Silas-Oliver/neurova/login-art.jpg

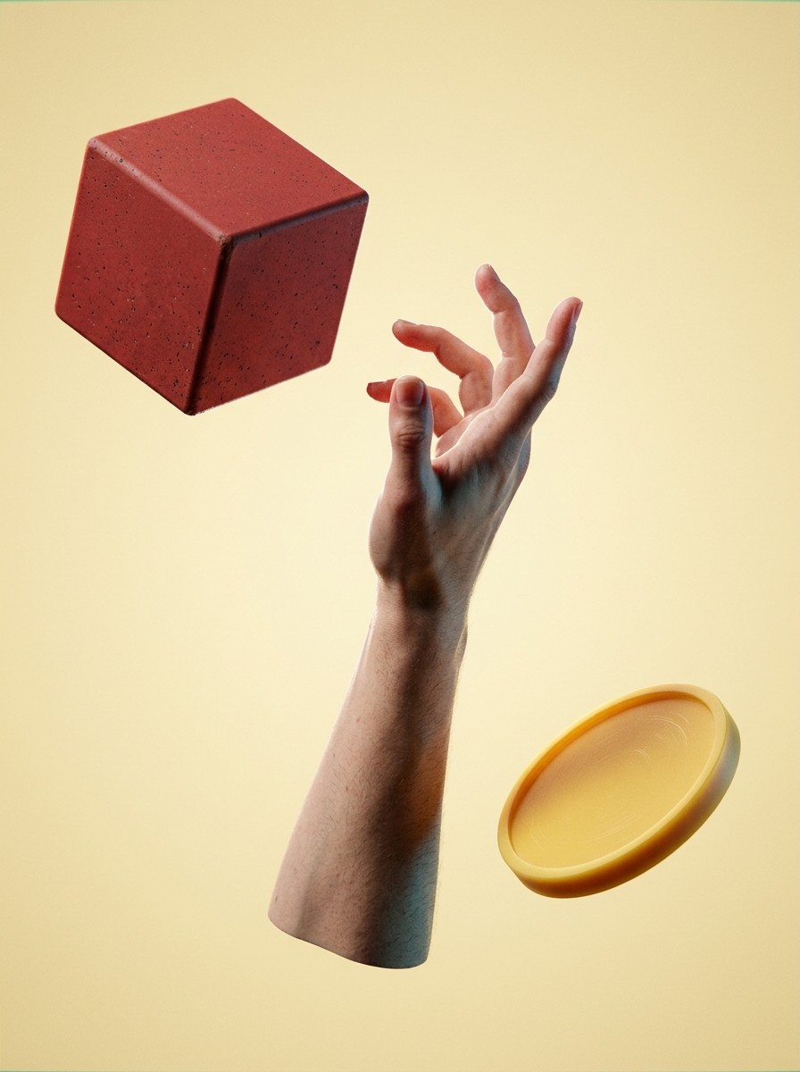
login-art.jpg
