Silas-Oliver/neurova/(commit log)

2026-09-26 EMG Tweak #2
    Retune the live view's detection constants for the real signal.
    Bench measurements finally gave concrete numbers: the module rests at
    344 and reaches 346-347 on a hard clench, with a peak-to-peak spread
    inside each sampling window of 0-1 counts. So the signal is 2-3 counts
    on a noise floor of roughly half a count -- far quieter, and far
    smaller, than the constants assumed.
    Those constants were tuned against an earlier, much noisier capture
    (339 +/- 5) and were blocking detection outright rather than protecting
    against false positives:
    - EMG_MIN_STDDEV_FLOOR 5 -> 0.5. One ADC count is the smallest real
    difference; a floor of 5 forced the baseline to look five times
    noisier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
2026-09-26 Plotter Tweak #2
    Stop onset markers from taking over the plot.
    Each detected onset was drawn as a full-height vertical rule. One is
    readable; several on screen at once dominate the plot and bury the trace
    they are supposed to annotate. The lower detection floor from the last
    change fires more often, which made this worse rather than better.
    Each onset is now a dot sitting on the smoothed trace, with a short tick
    at the top edge so it stays findable when the trace runs near the floor.
    That also says more than the rule did: a full-height line marks a moment
    in time but not where on the curve the onset was judged to happen, while
    a dot on the trace shows both.
    Refractory period also goes fro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
2026-09-26 Plotter Tweak #3
    One marker per contraction, and a quieter marker.
    Holding a clench produced two or three onset markers instead of one.
    Cause: real muscle is not steady while held, and that tremor re-crosses
    the slope threshold repeatedly. A fixed refractory cannot fix this --
    lengthen it enough to swallow the tremor and two genuine contractions
    close together merge into one.
    An onset now latches: it fires once, then stays quiet until the signal
    has fallen most of the way back toward rest. Judging the end of an
    excursion by where the signal actually is, rather than by a timer, marks
    one contraction once whether it lasts half a second or five, while two
    separate contractions still read as t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
2026-09-26 Plotter Tweak #4
    Show movement by colouring the trace instead of marking it.
    The smoothed line is now neutral while resting and green for the whole
    stretch the board judges to be a contraction, replacing the onset dots.
    Colouring the span says more than a marker did. A dot marks when a
    contraction started but nothing about how long it lasted; the coloured
    run shows both, and where it begins is still exactly the detected onset.
    It also annotates the plot without drawing anything on top of it, which
    is what made the previous markers crowd the view.
    The line is drawn in runs of consecutive same-state samples rather than
    as one path, each run starting a sample early so the runs join without
    g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
2026-09-26 Plotter Tweak #5
    Give the EMG live view the home page scope's instrument look.
    The panel now reuses the hero widget's furniture: the 22px graph-paper
    grid behind the trace, IBM Plex Mono labels, a large raw readout, and a
    footer stat row. The canvas is transparent and sits above the grid
    rather than covering it, so the trace reads against graph paper the way
    the home-page widget does.
    Trace colours move to the scope palette -- #5fbf8f for a contraction,
    #7fa89c while resting -- instead of the site's status green and white,
    so the plot belongs to the panel it sits in.
    The footer now carries information that was previously buried in a
    sentence: the captured baseline and the rise the board i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
2026-09-26 Plotter Tweak #6
    Tighten the EMG scope's layout and stop the trace ending short.
    Three things, all from looking at it rather than reasoning about it.
    The trace did not reach the panel edges. Two causes: the plot buffer
    started empty and grew in from the left, so the line only covered part
    of the width for the first several seconds and again after every
    restart; and a 2px stroke sitting exactly on x=0 only shows half its
    width. The buffer is now prefilled at the resting level once the
    baseline is known, and the x mapping insets by a pixel. The trace now
    spans column 1 to 598 of 600 from the first live sample.
    The panel was too airy. The hero scope can breathe because it is a hero;
    this one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
2026-09-26 Plotter Tweak #7
    Make a resting trace visibly live, and stop the baseline hiding under it.
    A flat signal gave no sign the plot was running at all. The panel's grid
    comes from CSS and is static, the trace does not move when the signal is
    steady, and the baseline was drawn before the trace, so at rest the
    trace sat exactly on it and covered it. Frozen and working looked
    identical.
    The canvas now paints its own copy of the grid -- same 22px pitch and
    weight, so it reads as continuous with the panel -- and scrolls the
    vertical lines with incoming samples. Data flowing is now visible
    regardless of what the signal is doing. Verified on a perfectly constant
    344: gridlines step 13,35,57 -> 4,26,48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
2026-09-26 Plotter Tweak #8
    Render the EMG canvas at native resolution, and keep one grid.
    The canvas element had a fixed 600x150 backing store but is laid out at
    100% of the panel width. Measured live that is 787 CSS pixels, so
    everything drawn on it was stretched 1.31x horizontally and not at all
    vertically, then resampled. Grid squares were not square, and the trace
    and gridlines were soft -- the "low quality" look.
    The backing store is now sized to the element's measured size times the
    display's pixel ratio, with the context scaled to match, so a pixel
    drawn is a pixel shown. On this display that is 1574x300 backing for
    787x150 CSS at dpr 2. Measured after the change, vertical and horizontal
    grid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
2026-09-26 Plotter Tweak #9
    Restore the scope look with a static grid.
    Brings back Plotter Tweaks #5 through #8 -- the instrument styling, the
    STATE / RAW / BASELINE / ONSET footer, the native-resolution canvas and
    the full-width prefilled trace -- without the scrolling gridlines.
    With the grid no longer moving, it goes back to being the panel's own
    CSS grid covering the whole card, the way the hero scope does it, and
    the canvas is transparent over it again. The canvas only had to paint
    its own grid in order to scroll it; a static grid drawn twice in two
    places was what could never line up.
    The canvas keeps its native-resolution sizing, which was never about the
    grid: the element is laid out at 787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
2026-09-26 Plotter Tweak #10
    Travel the baseline's dashes with the data.
    A steady signal made the plot indistinguishable from a frozen one, which
    is what the scrolling grid had been there for before it was dropped for
    never lining up with the panel's own grid. The baseline is a better
    place for that cue: it is one line the canvas already owns and draws
    last, so it cannot fall out of alignment with anything.
    Its dashes now advance at the same pixels-per-sample the trace scrolls
    at, so the line visibly travels whatever the signal is doing.
    The gap is three times the dash rather than equal to it. A sample
    advances the pattern by w/199 pixels, near 4, so the original 8px period
    stepped half a period per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
2026-09-26 Menu Tweak #1
    Clean up the test menu, and fix its Calibrate copy.
    The Calibrate card read "Record a baseline with no electrodes on skin."
    That is the opposite of what calibration is: the screen it opens says to
    place the electrodes at your best, firmest contact first. A baseline
    captured off-skin would be meaningless and every later verdict would be
    judged against it, so this is worth fixing regardless of the layout.
    Layout: five cards in a two-column grid left an orphaned fifth cell, and
    all five carried the same visual weight despite being three different
    kinds of thing -- two that work, two that do not exist yet, and a bench
    tool that is not a test at all.
    The four real tests now fill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
2026-09-26 Menu Tweak #2
    Relay the test menu as one sequence instead of a grid of cards.
    The grid was the wrong shape for what this is. The tests are a sequence,
    not a set of equal choices -- a contact test means nothing without a
    calibration behind it -- but four identical boxes said the opposite, and
    a fifth card for a bench tool that is not a test at all had nowhere to
    sit. The panel also forces a 340px minimum height while the grid carried
    margin-top:auto, so the cards floated in the middle of a mostly empty
    box.
    They are now one bordered list of numbered rows, matching the 01/02/03
    step list already used on the Calibrate screen, so the two screens share
    an idiom. Each row is an index, a name, a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
2026-09-26 Data Tab #1
    Log real sessions, and make the Data page show them.
    Every calibration and contact test now writes a dated record to
    users/{uid}/sessions -- the subcollection the existing security rule's
    {document=**} wildcard already covers. Writes are fire-and-forget: a
    session that fails to save must never interrupt a test already run on
    someone's arm.
    Each record carries the circuit it was measured through. The firmware
    gained a CONFIG line reporting its fixed resistor and ADC reference, and
    the site attaches those to every session, for the same reason the EEPROM
    stores them beside the baseline: a resistance is only comparable against
    another taken through the same divider, so a resistor s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
2026-09-26 Data Tab #2
    Reload the Data page on every visit, not just the first.
    Sessions are written by running a test on the Test menu, so the common
    path is to log one and come straight here -- and loading once per page
    load meant exactly that session was the one missing, until a manual
    refresh or a reload. The read is small, and a superseded load already
    discards its own result, so reloading per visit is safe.
    Verified: log a calibration while on another page, return to Data, and
    the new session is at the top of the log with the baseline chart going
    from three points to four.
2026-09-27 Account Tweak #2
    Light theme for the sign-in page, and close the gap down its middle.
    Drops the dark treatment for the site's own palette -- background,
    panel, borders, teal primary and ink all come from the existing
    variables, so the page no longer jumps from dark to light on the way
    into the tool. The card, buttons and inputs go back to inheriting the
    site's styles rather than overriding them, which is also less to keep in
    step later.
    The gap: the grid filled the viewport and each of its two columns
    centred its own contents, so on a wide screen the form drifted left and
    the artwork right, leaving a void between them that grew with the
    window. Measured at 1440px it was about 550px across.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
2026-09-27 Account Tweak #3
    Scale up the sign-in page.
    Everything grows together rather than a few pieces in isolation: the
    grid cap 1080 to 1260, the headline 40 to 52, the form and card 390 to
    450, the artwork 440 to 560 wide, and the card's own padding, labels,
    inputs, buttons and toggle by matching amounts. Scaling one element
    alone would have thrown the proportions between them.
    Measured at 1440x900: card 450, artwork 558x747, a 64px gap, no
    horizontal overflow and the artwork still inside the viewport height.
    Checked at 900px too, where both columns shrink together on
    minmax(0,1fr) and nothing overflows -- worth confirming, since fixed
    widths at these sizes would have blown out the layout betwe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
2026-09-27 Account Tweak #7
    Passwordless email-link sign-in on mobile, with onboarding.
    Mobile now asks for an email and nothing else. Firebase mails a link,
    following it signs the person in, and whether that returns to an account
    or creates one is the same action either way -- so there is no sign-up
    versus log-in mode to toggle between. Google sits above it unchanged,
    and a quiet "Use a password instead" link swaps in the old form for when
    an email is slow or lands in spam. Desktop keeps the password form it
    already had.
    The address is stashed in localStorage before the link is sent, because
    the link does not carry it and Firebase needs it back on return. Opening
    the link on a different device finds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
2026-09-27 Account Tweak #8
    Tell people where the sign-in email actually lands.
    Firebase's own status dashboard acknowledges that authentication mail
    from firebaseapp.com goes to spam or never arrives -- the domain is
    shared across every Firebase project and phishers have abused it enough
    to damage its reputation for everyone on it. That is not fixable from
    this side without a custom sending domain.
    So the wait screen now says so plainly: check spam, and here is the
    exact address to look for. Naming the sender is the part that actually
    helps, since a filtered message is findable once you know what it is.
    Also adds a resend button, for when the first one is lost rather than
    filtered.
    The sender addr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
2026-09-27 Account Tweak #10
    Fix the confirm-email rejection and the password-fallback dead end.
    Confirming the address after opening a sign-in link on another device
    always failed with "that doesn't look like a valid email address", even
    when the address was right. The handler re-rendered the panel before
    reading the field, and re-rendering replaces the input with a fresh
    empty one -- so it submitted an empty string, which Firebase correctly
    rejected as not an email. The value is now read first. Checked the other
    handlers for the same ordering; they all read before re-rendering.
    The password fallback was a dead end. "Use a password instead" only
    exists on the link screen, so once it swapped the form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
2026-09-27 Account Tweak #12
    Make auth failures say what actually failed.
    "Something went wrong" is the fallback for an unmapped error code, and
    every failure mode of the email-link flow was landing on it. Firebase
    was reporting exactly what was wrong each time and the mapping threw it
    away, which is why this took several guesses instead of one look.
    Mapped the codes that flow can actually produce, each naming the setting
    to change: operation-not-allowed points at the email-link toggle,
    unauthorized-continue-uri at the authorized domains list, and the
    action-code ones say the link was used or expired rather than implying
    the address was wrong.
    Every auth failure now goes through one reporter that lo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
2026-09-27 Account Tweak #13
    Handle the email-link daily quota.
    The failures were auth/quota-exceeded. Firebase's no-cost plan allows
    five email-link sign-ins per day for the whole project; Blaze allows
    25,000. Testing this flow repeatedly used them up, and every attempt
    since has been the quota rather than anything broken. It probably
    accounts for the earlier failures too.
    The quota is on the Firebase operation, not on delivery, so neither the
    custom domain nor custom SMTP raises it.
    Named the code, and since no amount of retrying fixes a daily limit, the
    form now switches to the password one when it happens -- Google and
    password sign-in have no equivalent cap, so the two routes that still
    work ar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
2026-09-27 Account Tweak #14
    Switch passwordless sign-in off, without removing it.
    Five email links a day across the whole project is not enough to put in
    front of anyone, so mobile goes back to Google plus name, email and
    password — the form as it stood before the link flow replaced it.
    One flag does it. Everything the link flow needs is still here and still
    compiles: the send, the wait screen with its resend, the return handler,
    the different-device confirmation, the three onboarding steps and the
    quota message. Setting PASSWORDLESS_SIGNIN_ENABLED back to true brings
    all of it back, which is worth doing if this ever moves to Blaze, where
    the same limit is 25,000 a day.
    Two things deliberately no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
2026-09-27 Firmware Version Control
    Bring the Arduino sketch under git. It had been living only in the Arduino sketchbook,
    untracked, while accumulating the EEPROM baseline store, the SETBASELINE/STATUS/FORGET
    protocol, oversampled ADC reads, the digital-pin-driven ratiometric divider and several
    rounds of contact-path guard work -- all of it one bad save from gone, with no way to
    diff a regression against a known-good build.
    The sketch is now the repository's copy at firmware/ContactTest-Final.ino, and the
    sketchbook entry is a symlink to it. The IDE opens, compiles and flashes exactly as
    before (verified: compiles through the symlink at 41% flash, 67% RAM), so there is no
    new habit to keep and no se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
2026-09-27 Serial Tweak
    Add single-digit shortcuts to the serial console. Typing CALIBRATE and
    EMG_STREAM_START by hand through a long tighten-something-and-measure-again loop is
    slow and is its own source of typos, so 1-9 now stand in for the nine commands and 0
    repeats whichever ran last. The menu prints on boot and answers MENU or ?.
    The full command words are unchanged and remain what the website sends -- this only adds
    an alias layer ahead of the existing dispatcher. The digit table lives in PROGMEM and
    the menu strings in F(), since RAM is the constrained resource here (68% used) while
    flash is not (44%). The last command is recorded before dispatch rather than after, so 0
    still repeats it when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
    [ContactTest-Final.ino]
2026-09-28 Contact Circuit Tweak
    Drop the divider from 1 MOhm to 100 kOhm and account for the EMG module's loading, so
    the contact check and the EMG module can share three electrodes with the jack left
    plugged in. No analog switch, no capacitors, no extra parts.
    The earlier conclusion that a CD4066 was required rested on a DIAG taken with electrodes
    on the arm, where body leakage sat in parallel with the module and made its input look
    like a ~3 kOhm short -- soft enough that nothing could be measured through it. Repeating
    the measurement with the jack in and no electrodes attached isolates the module: the
    HIGH-vs-LOW swing is 60.5 counts, not 3, which puts its input at ~63 kOhm to a 1.40 V
    bias. Those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
    [ContactTest-Final.ino]
2026-09-28 Contact Circuit Tweak #2
    Make the settle delay adjustable at runtime with SETTLE:<ms>, to find out why the EMG
    module's input impedance does not measure consistently.
    Derived from the HIGH-vs-LOW swing, the module's input came out at ~63 kOhm against a
    1 MOhm divider and ~8 kOhm against a 100 kOhm one. The bias solves to 1.40 V and 1.51 V
    respectively, so the two measurements agree on the bias and disagree eightfold on the
    impedance. A passive resistor cannot do that, so the input is not one -- most likely
    AC-coupled or actively biased, and still charging when the reading is taken 50 ms after
    the drive pin moves.
    That matters beyond tidiness: the 63 kOhm figure is what the divider was size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
2026-09-28 Firmware Tooling
    Add firmware/flash.sh to build and upload from the command line, bypassing the Arduino
    IDE.
    The IDE holds an open sketch in memory and never reloads a file changed on disk, so edits
    made outside it stay invisible -- and because it writes that in-memory copy back to disk
    before compiling, an upload silently discards those edits and flashes the previous build.
    That has now cost two rounds of "the code hasn't updated" and one near-miss where a stale
    buffer would have overwritten the working source.
    Uploading from the shell removes the failure mode rather than working around it: the file
    on disk is what gets built. The IDE's Serial Monitor still holds the port, so it has to be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
2026-09-28 Contact Circuit Tweak #3
    Set the EMG module's shunt model from the settled measurement, and raise the settle delay
    to match.
    The settle sweep answered the earlier inconsistency: the HIGH-vs-LOW gap runs 49 -> 108 ->
    121.18 -> 121.21 counts at 50/250/1000/3000 ms and then stops. The module's input is
    capacitive, every reading before this was taken mid-charge, and the eightfold disagreement
    between the 1 MOhm and 100 kOhm measurements was an artifact of reading a partly charged
    node rather than anything about the module. Settled, it is ~13.4 kOhm to a 1.03 V bias,
    which predicts the measured 305.41 to within two counts.
    The consequence is worse than the earlier estimate implied, and it rever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
2026-09-28 Contact Circuit Tweak #4
    Add an AC contact measurement alongside the DC one: AC, or AC:<halfPeriodMs> to sweep
    frequency.
    The DC check measures the wrong quantity for a dry electrode. Dry skin's outer layer is
    close to an insulator at DC, so a well-seated dry electrode reads 304 counts against 307
    for nothing connected at all -- a verdict of "no contact" on contact that is physically
    fine. At EMG frequencies that same layer behaves as a capacitor and the interface falls by
    two or three orders of magnitude: 1.3 MOhm at DC against roughly 67 kOhm at 50 Hz, same
    arm, seconds apart. Water is what made the DC check work all day, and it cannot be relied
    on in the finished device, so the measureme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
    [ContactTest-Final.ino]
2026-09-28 Contact Circuit Tweak #5
    Drive a relay on D4 that disconnects the EMG module from the electrodes for the duration
    of a contact measurement.
    The module's inputs carry roughly 10 uF to ground. That was measured two independent ways
    and the figures agree: as a 1.1 s DC settling time against the 113 kOhm the junction sees,
    and as an impedance of 1281 / 236 / 125 ohms at 10 / 50 / 100 Hz, falling inversely with
    frequency exactly as a capacitor does. Unplugging the jack takes the AC amplitude from 1.3
    counts to 996, so it is the module and not the wiring.
    That rules out the alternatives rather than merely disfavouring them. Series capacitors
    pass AC by definition, so they cannot isolate an AC me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
2026-09-28 Contact Circuit Tweak #6
    Move calibration and TEST onto the AC measurement, and report EMG as excursion from rest
    rather than raw level.
    The contact check ran on DC while the AC path existed only as a diagnostic, so the check
    itself still could not see a dry electrode. DC reads dry skin as 1.3 MOhm, which is
    indistinguishable from an electrode lying on the bench, and swung 69 kOhm to 21.5 MOhm
    across today on unchanged hardware. At 500 Hz the same interface reads 127-142 kOhm and
    repeated within 12% hours apart. Calibration and TEST now both measure through
    measureContactImpedance(), so the check runs on the quantity that is actually readable and
    actually stable.
    500 Hz because it was the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
2026-09-28 EMG Tweak
    Close the relay before the EMG settle rather than after it.
    EMG_STREAM_START turned the contact circuit off, waited EMG_SETTLE_MS for the amplifier to
    recover, and announced itself -- and only then did the command dispatcher reconnect the
    module, because reconnection happens centrally after every command. So the relay closed
    after the settle had already elapsed. Closing it steps the module's inputs, which is
    exactly what the settle exists to ride out, so the first samples came from the middle of
    that transient. Those are also the samples the new resting level is learned from, which
    put the baseline somewhere meaningless and made every later excursion wrong.
    The relay now closes b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
    [ContactTest-Final.ino]
2026-09-28 EMG Revert
    Put the EMG path back to exactly what it was in 2026-09-28e, where it worked: 710 at rest,
    350 at full clench, graded by effort. Verified byte-identical to that build for both the
    EMG_LIVE output and EMG_STREAM_START; the AC contact check is the only thing that differs.
    The changes being reverted were made for the website's benefit, not the board's. The site
    plots the leading number from EMG_LIVE and its onset detection looks for steep rises, so an
    output that falls on a clench would be misread there. That is a real problem, but it lives
    on the website, where inverting costs one line and can be tested without reflashing.
    Instead the firmware's working measurement path gained rest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
    [ContactTest-Final.ino]
2026-09-28 EMG Tweak #2
    Flip the EMG signal's polarity on the website, where it belongs.
    This module's envelope falls as the muscle works: about 790 at rest and 350 at full
    effort, graded in between. Confirmed as real muscle activity rather than a movement or
    contact artifact -- an isometric contraction with no visible movement produces the same
    swing, while pressing hard on an electrode produces none. The earlier flat readings were a
    gain setting, not a fault.
    Onset detection, peak tracking, the event-end test and the plot are all written around a
    signal that rises with effort, so a falling one would have been read as rest throughout.
    The sample is flipped once as it enters feedEmgSample rather than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
2026-09-28 Plotter Tweak
    Let the EMG chart's vertical axis open up for a real contraction.
    The axis was fixed at baseline capture from the resting standard deviation, which is
    deliberately tight so that small movements are legible. Now that the signal is working and
    a clench swings hundreds of counts against a resting wobble of a few, every contraction
    ran off the top of that scale and flattened against the edge -- hiding the part actually
    worth looking at.
    The baseline-derived range becomes a minimum rather than the whole story. It still sets
    how sensitive the chart is at rest, so a small movement is as visible as it was, and the
    axis grows only as far as the points currently on screen require, with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
2026-09-28 Plotter Tweak #2
    Make the calibration progress ring match how long calibration now actually takes.
    The ring was built around a 2500 ms window, matching the old DC sampling loop. Moving the
    check to AC roughly tripled the real duration, so the ring reached full and then sat there
    for several seconds on every run, which reads as a hang rather than as progress.
    The sequence now comes to about 6.6 s:
    relay settling before the measurement ~15 ms
    the path check, two reads either side of a 1200 ms settle ~2470 ms
    10 samples x (32-cycle AC measurement ~73 ms + 300 ms gap) ~3730 ms
    printing each sample's line back at 9600 baud ~420 ms
    Set to 6800 rat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
2026-09-28 Mobile Tweaks #4
    Fix the tab bar doing nothing until a refresh, and replace the phone home screen with a
    dashboard.
    The tab bug was mine and it was ordering. shared.js binds click handlers to every
    [data-nav] element once, at load. The tab bar markup sat after that script tag, so it had
    not been parsed when the binding ran and no tab was ever wired up -- the href changed the
    hash, which is why it appeared to work after a refresh and nowhere else. The nav now comes
    before the scripts. Verified by clicking a tab: the page and the active tab both change
    with no reload.
    The home screen was the deeper complaint. The desktop home opens on an explanation of the
    product, which is right in a browse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
2026-09-28 Mobile Tweaks #6
    Fix three things the last pass broke or missed on the phone.
    Session log was unreadable. .mini-feed is a deliberately dark terminal readout -- #132622
    with pale #dce9e3 text -- and the mobile layer overrode only its background to white,
    leaving pale text on white. The override now changes just the radius and padding and
    leaves the colours alone.
    Log out and Export my data had lost their frames. Making .btn-ghost borderless on mobile
    was meant for the hero's secondary action, which really is a link onward, but it applies
    to every ghost button and turned that pair into bare text that reads as links rather than
    the two buttons they are. They now get iOS's tinted secondary tre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
2026-09-28 Branding Tweak
    Split the company name from the product name: Neurova is the company, Reach is the glove.
    Header chrome on both layouts now reads Neurova rather than "Recovery Glove", since that
    is the company's mark and belongs in the nav. The two places that name the device itself
    -- the status panel's label and the mobile dashboard's title -- become Reach.
    Everywhere else "glove" stays, because it is the noun for the physical object rather than
    a name: "a compression glove that watches how a damaged nerve recovers", "electrodes built
    into the glove", "put the glove on", "the glove's board". Substituting a product name into
    those makes them ungrammatical, and the prose needs both words an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
2026-09-28 Branding Tweak #2
    Punctuate the status label as "REACH: STATUS", and give the product name a treatment of
    its own so it reads as a name.
    Reach is an ordinary English word as well as a name, so in running text it can be taken
    for the verb and disappear. Wrapping it in .product-name and setting it in the display
    face with tightened spacing marks it as a proper noun at a glance, which is the job a
    wordmark does, without resorting to capitals or a trademark symbol.
    The treatment adapts to where it sits rather than being one fixed style. In body contexts
    it takes the brand tint. Inside the dark status panel the green is too low-contrast, so it
    takes the panel's own bright ink and separates itse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
2026-09-28 Mobile Tweaks #7
    Give the Test menu and Account tabs the same tightened top spacing as the others.
    Every sub-page's wrap carries an inline 56px top padding meant for desktop, which on a
    phone is most of a screen of nothing before the content starts. The rule that overrode it
    named #page-data and #page-specs individually, so the other two kept the desktop value --
    which is exactly the failure mode of listing pages by hand.
    It now matches any .page > section > .wrap, so the four existing sub-pages and any added
    later are covered without being enumerated. The home page is unaffected, since its .wrap
    is an ancestor of .page rather than a child of its sections.
    Verified: all four now compute t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
2026-09-28 Flex Sensor
    Add a FLEX command reading a flex sensor on its own pins.
    The sensor is a resistor that changes with bend angle, wired as the top leg of a divider
    between D5 and A2 with a fixed resistor to ground. It shares nothing with the contact
    check or the EMG module -- different pins, different node, no relay and no switching --
    so it cannot interfere with either and neither can interfere with it.
    Driven from a pin rather than the 5V rail for the same two reasons the contact divider is:
    the firmware can release it to high impedance between reads, and the measurement becomes
    ratiometric, so supply sag cancels out of the ratio instead of skewing every reading.
    Being purely resistive, it n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
    [ContactTest-Final.ino]
2026-09-28 Flex Sensor #2
    Add flex calibration and a live stream, mirroring how the contact check and EMG work.
    Raw counts mean nothing on their own: where the strip sits on the finger changes them from
    one wearing to the next, the same way electrode placement moves the contact baseline. Two
    captures -- FLEXCAL:FLAT with the hand open, FLEXCAL:BENT with it closed -- record the
    wearer's own endpoints, and everything after is reported as a percentage of that range,
    which is comparable between sessions. 0% is flat, 100% is fully closed.
    The percentage is deliberately not clamped, so a reading past either end stays visible
    rather than being quietly hidden by a calibration that has drifted.
    Each endpoint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
    [ContactTest-Final.ino]
2026-09-30 Diagnostics
    Add a RAIL command that measures the EMG module's positive supply, turning the Arduino
    into a voltmeter for the one quantity we could not otherwise see.
    The LED test only proves a rail exists -- an LED lights from roughly 2 V upward -- and the
    way a resistive virtual ground fails is by drifting off centre, not by disappearing. A
    supply sitting at +7 V and -2 V lights both LEDs and is still below the sensor's +/-3.5 V
    minimum, so every reading taken on it is meaningless. Without a number, an unbalanced
    supply and a dead sensor look identical from the serial monitor, which is where the last
    several hours went.
    +Vs reaches A3 through a 100k/100k divider, so even a full 9 V arrives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
    [ContactTest-Final.ino]
2026-10-01 Diagnostics #2
    Make the RAIL measurement trustworthy. The readings it produced were unstable, and the
    instability was the measurement, not the circuit.
    A 100k/100k divider presents about 50k to the analog pin -- five times past the ATmega's
    10k source-impedance limit. The sample-and-hold cannot refill between conversions at that
    impedance, so readings come out biased low, drift, and depend on whichever channel was
    sampled before. The same configuration read 10 V and then 5.86 V minutes apart, and
    conclusions were drawn from both.
    This is the identical trap as the original 1 MOhm contact divider, which cost a day and
    was solved with oversampling and settling delays. I built the rail divider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
    [ContactTest-Final.ino]
2026-10-03 Diagnostics #3
    Add CHECK and CHECK:SAVE, which measure the whole rig in one command and compare it
    against a snapshot taken when it was working.
    The recurring problem on this build has not been getting an EMG signal. It has been
    getting back to one. Four or five times now the rig has worked, then stopped, and no
    amount of adjusting has recovered it -- because the setup is not mechanically
    deterministic and every session starts from a slightly different physical state. A pin
    rattling in a barrel plug, a 3.5 mm jack, three unsecured leads and a breadboard are all
    variables, and chasing the signal by adjusting them explores that space at random.
    Notably one subsystem already is reproducible: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
    [ContactTest-Final.ino]
2026-10-03 Flex Sensor #3
    Give the website flex sensor support. The firmware has had FLEX, FLEXCAL:FLAT/BENT and a
    FLEX_LIVE stream for days, and none of it was reachable from the site -- the flex sensor
    appeared in the Specs copy and the wiring diagrams but existed nowhere in the code. Half
    the measurement system was working on the board and invisible to the thing that reads it.
    Adds a Flex sensor screen to the test menu with the two calibration captures, a live
    bend-angle view and a plot, on both layouts.
    Calibration is the point of the screen rather than a preamble to it. The raw reading
    depends entirely on how the strip is sitting on the finger that day, so it means nothing
    until it has both ends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
2026-10-03 Desktop Overhaul
    Rework the desktop visuals around the patterns in the land-book examples, scoped to
    .force-desktop so the phone layout is untouched.
    The two most relevant examples were a wellness site and an editorial camera site, and both
    did the same three things: display type far larger than conventional scaling, full-width
    colour bands instead of boxed columns, and chrome kept quiet so the content carries the
    page.
    Type scale. The hero was 42px, which is a large paragraph rather than a display size. It
    is now 72px with tighter tracking and a line height of 1.0, and section headings go from
    whatever they were to 44px on a 20ch measure. Body copy comes up to 17-19px, since 15px
    body und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
2026-10-03 Home Rebuild
    Rebuild the home page around the Ecoriz template's actual patterns rather than nudging the
    old layout, which was the fair criticism of the last attempt.
    What that template does, and what is now done here: a pill label above every section, a
    two-line heading whose second line is muted, cards within one row that are deliberately
    different from each other, big numerals used as graphics, hard-rounded corners, pill
    buttons, one line of copy per item, and a giant ghosted wordmark to close on.
    Where it uses photography, this uses the measurements. There are no product photos to
    show, but there are numbers worth looking at, and they were buried under prose while
    paragraphs did the wor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
2026-10-03 Home Rebuild #2
    Scrap the home page and rebuild it as an instrument rather than a landing page.
    Everything that was there is gone: the hero prose, the stat row, the roadmap carousel, the
    "why contact quality" essay, the under-the-hood section. None of it was essential and all
    of it was paragraphs doing the work of filling space.
    What replaces it is what the page is actually for. A dark panel carrying the device's
    state, with the current reading set at 96-168px as the largest thing on the screen, the
    EMG trace running behind it, connection state, three measurement chips and a connect
    button. Then five tiles into the tests, in two rows that tile a six-column grid exactly --
    two halves, then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
2026-10-03 Ecoriz Layout
    Two changes: remove every invented reading, and rebuild the home page section for section
    against the Ecoriz template.
    No mock data. The panel previously showed 128 kOhm, a contact verdict of Good, 1.62 V and
    a baseline of Set, with nothing connected. All of it was made up. Disconnected it now
    shows a dash, which is information -- it says there is nothing to show. A plausible number
    says something false. The count-up animation went with it, since there is no longer a
    placeholder to count towards.
    The layout now follows the template: rounded dark hero with a pill badge, two-line
    headline, one line of copy, pill CTA and a floating glass card overlaid bottom right; a
    logo strip;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
2026-10-03 Home Content
    Five content fixes. The layout is unchanged -- only what sits inside it.
    The four step cards were empty dark panels, which is what a photo slot looks like with no
    photo in it. Each now carries line art for what the step actually is: a hand, a gauge, a
    waveform, a trend line.
    The why cards held 200px minimums with content at the top, so every card was a third
    empty, and the accent card had the same gap around its figure. They now size to their
    content -- 119px rather than 200 -- and the figure centres. The grid still aligns, because
    row height comes from the tallest card.
    The accent band rotates. Four claims, one at a time, changing every ten seconds with a
    fade and clickable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
2026-10-03 Home Content #2
    Five fixes, layout untouched.
    The spec strip is gone. "No gel" is a fact about the engineering rather than something a
    reader wants, and the rest of the row was no better.
    The traces were ECG, not EMG. Isolated sharp spikes on a flat line is what a heartbeat
    looks like; surface EMG is dense bipolar noise whose amplitude swells during a contraction
    and settles between. Both the hero and the muscle-activation card now carry generated
    geometry with that shape -- quiet stretches, bursts where the muscle works -- and the
    run-a-test icon is redrawn the same way rather than keeping the spike.
    The rotating band cycles the tests themselves, in the order the test menu runs them:
    con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
2026-10-03 Home Content #3
    Revert the trace geometry and the hand to the previous versions, and restore the gap below
    the hero.
    The ECG-shaped traces are back in the hero, the muscle-activation card and the run-a-test
    icon, and the original hand drawing with them. The generated EMG geometry was more faithful
    to what the sensor actually produces but read worse at these sizes -- a dense band of noise
    is visually flat, where a spike has a silhouette. Treating them as graphic marks rather
    than readings.
    Removing the spec strip also removed the spacing it was providing between the hero and the
    first section, which left the Features pill sitting against the panel. The hero carries
    that 104px itself now rat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
2026-10-03 Contact Fault Detail
    Firmware: "no contact" was printed for both failure directions, so a failed
    calibration said nothing about why it failed. The two cases are opposite faults:
    the junction following the drive in full means nothing is shunting it to ground
    (open line, electrodes off skin), while the junction refusing to move means
    something is pinning it (a short, or a load heavy enough to look like one - the
    EMG module's input does this at AC, and the relay that used to isolate it is no
    longer on the breadboard). Calibration now names which one, prints the last
    swing as a percentage of the drive, and gives the matching next check.
    Site: the hero panel's reading was a dash in both branches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
    [ContactTest-Final.ino]
2026-10-03 Calibration Agreement
    Calibration counted how many samples were valid and never asked whether they
    agreed. A run near open circuit produced samples from 835k to 1.42M ohms -- a
    70% spread -- and the mean of that, 1030934, was stored as a baseline and
    reported as a clean number. It passed the existing bounds check because the
    plausible range tops out at 20M, which is there to catch a broken circuit, not
    to judge contact quality.
    The cause is the shape of Z = R*f/(1-f). Near f = 1 the curve is almost
    vertical: at 930 counts of 1023 one ADC count moves the answer about 40k ohms,
    so a 22-count wobble spans half a megohm. Good contact in the glove sits at 283
    counts and repeats to 1%, where the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
    [ContactTest-Final.ino]
2026-10-03 Settling Vs Scatter
    The spread gate let a 1397488 ohm baseline through at 19.1% and stored it. That
    is the worst possible outcome, because the baseline is what every later verdict
    is measured against: at a 1.5x multiple it sets the pass mark at 2.1M, and
    electrodes hanging in free air measure 2.6M. Nearly anything would have passed
    the contact test afterwards.
    Two gaps. First, nothing checked that the baseline was good contact at all --
    the only ceiling was the 20M plausibility bound, which exists to catch a broken
    circuit. Measured good contact in the glove is 38k, hard finger pressure 64k,
    and dry electrodes at 500 Hz top out near 267k, so a separate 400k ceiling now
    rejects a reference t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
    [ContactTest-Final.ino]
2026-10-03 Flash Strings
    Every build warned about low memory: 1543 of 2048 bytes of SRAM in use, 505
    left for the stack. 1054 of those bytes were string literals. On AVR a literal
    is copied from flash into SRAM at boot unless it is wrapped in F(), so two
    thirds of memory was being spent to hold text that is printed once and never
    read back. 83 literals were already wrapped and 54 were not.
    Wrapping the rest drops globals to 609 bytes, 29%, and raises stack headroom
    from 505 to 1439 bytes. Flash cost is 138 bytes. F() changes only where the
    bytes are stored, never what is printed, so the machine-readable lines the
    website parses are untouched -- verified by diffing every literal in the file
    before and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
2026-10-03 Contact Stream
    Seating an electrode is a mechanical problem, and AC:1 is the wrong instrument
    for it. A single reading cannot show whether a number is steady or jumping,
    which is the only thing that distinguishes bad contact from intermittent
    contact -- and the readings that prompted this ranged 38 to 904 counts, from
    3.9k to 760k ohms, on the same electrode under the same hand.
    CONTACT_STREAM_START prints amplitude, ohms, and a running min and max four
    times a second, so the glove can be adjusted while watching the number instead
    of typing a command after every change. The running extremes matter more than
    the instantaneous value: a dropout between two prints would otherwise go
    unseen, and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
    [ContactTest-Final.ino]
2026-10-04 Dropout Counts
    The face-to-face wiggle test returned 0.0 counts live with a running max of
    204464 ohms. Two electrodes pressed metal to metal cannot measure 204k, so the
    circuit is opening somewhere in the leads, snaps or jumpers. That accounts for
    the scattered calibration runs, the 38 to 904 count swing under hand pressure,
    and why the glove read 283/286/285 one day and megohms the next.
    The stream understated it. Min and max only update on samples that carry an
    impedance, so a sample that goes fully open or fully pinned was dropped
    silently -- hiding the worst events behind a range that still looked bounded.
    The 204k was only the excursions that happened to land mid-scale.
    Opens and pin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
    [ContactTest-Final.ino]
2026-10-04 Low Impedance
    Loading the electrode from outside the glove brought contact to about 1500
    ohms, settling from 7300. That is 400x better than this morning and 25x better
    than the best the glove ever gave, and it breaks two thresholds that were set
    when nothing had ever read below 20k.
    The pass mark was baseline x 1.5, which is the right rule across the middle of
    the range and wrong at the bottom: a 1500 ohm baseline sets it at 2200 and
    would report 5k as poor contact, better than anything measured here before
    today. The amplifier cannot tell the difference either way, its input impedance
    being megohms. Contact now passes if it beats either the multiple or a flat 20k,
    so an unusually good base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
    [ContactTest-Final.ino]
2026-10-04 Relative Spread
    Calibration kept failing on spread while the readings were in fact consistent.
    Spread is measured as (max - min) / mean, which stops meaning anything once the
    readings are small: at 1500 ohms one ADC count is worth about 100, so a
    two-count wobble is a 27% spread and trips a 25% gate. Quantization alone was
    failing runs that represented the best contact this rig has produced.
    Same error as the pass mark fixed in the previous commit -- a relative rule
    applied at the bottom of a range where it does not hold. The baseline reaches a
    verdict through exactly one path, the threshold, and that is now the greater of
    baseline x 1.5 and a flat 20k. Below the crossover at 13333 ohms eve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
    [ContactTest-Final.ino]
2026-10-04 Hover Reflow
    Two home page fixes.
    The repeatability card read "Glove on, glove off, three times over", which
    describes the protocol that produced the number rather than what the number
    means to anyone reading it. It now says what the 1% is for: a change in the
    reading is a change in you, not in how the glove went on.
    The test list rows slid right on hover by adding 12px of padding to one side.
    Padding comes out of the content box, so the middle 1fr track lost 12px at the
    moment of hover -- enough to wrap the last word of Calibration's description
    onto a second line and jump the row height. Total horizontal padding is now
    constant at 20px and the slide moves it between the two sides, so the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
2026-10-04 Wiring Notes
    Answering "what was the wiring when we got 1%?" meant searching a 38 MB
    conversation transcript, because the repository documented the firmware and
    nothing about the board it runs on. A reading is only evidence if you know what
    produced it, and none of these readings had that attached.
    Records the row-by-row layout, the pin map, the known-good checks for each zone,
    and the measured contact impedance for every condition tested so far, from a
    short at under 150 ohms to free air at 2.6M.
    Two things in here are not deducible from the circuit. The EMG jack has to be
    unplugged for any contact measurement, because the module's 10 uF input is about
    32 ohms at 500 Hz and shorts the jun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
2026-10-04 Burst
    Readings swung between 36 and 900 counts with no pressure applied at either
    extreme, mostly uncorrelated with pressing. Three mechanisms could move the
    number and they have different shapes: moisture drifts slowly in one direction,
    pressure tracks the pressing, and a loose joint jumps between two states with
    almost no time in between. Only the third is bimodal.
    Nothing here could see that. The stream samples at 250 ms, which aliases
    chatter into apparent randomness, and every measurement averages 32 cycles,
    which destroys the distinction outright -- a mean of 400k says nothing about
    whether it was 400k throughout or alternated between 2k and open.
    BURST takes 200 single-cycle samples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
    [ContactTest-Final.ino]
2026-10-04 Excursions
    A burst that ran from 1892 to 2741665 ohms inside 888 ms printed the same
    verdict as one that held 1.1M throughout. Four samples out of two hundred
    cleared no percentage threshold, so the bucket counts called both "steady, no
    usable contact" while the range line told a completely different story.
    The ratio catches what the buckets miss. Nothing about skin moves three orders
    of magnitude in under a second, so a range spanning 20x or more is mechanical
    make-and-break no matter how few samples show it -- and a rare excursion is
    still the most important thing in the run, because it proves good contact is
    reachable from exactly where the electrode is sitting.
2026-10-04 Capacitor Reversal
    Records that the series-capacitor plan for sharing the electrodes can no longer
    work, and why, because it was the plan of record and parts were nearly ordered
    against it.
    It relied on the contact check driving DC: capacitors in each lead would give
    the electrode side a DC path to A0 and D3 while the module saw only AC. The
    contact check now drives a 500 Hz square wave, which is inside the EMG band of
    20-500 Hz, so no high-pass separates them -- the drive would reach the amplifier
    and the module would keep loading the divider. Switching to AC invalidated the
    approach at the time and neither of us noticed for days.
    An analog switch replaces it, which is what moduleSwitch()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
2026-10-04 Diagnostic Plan
    Every EMG attempt so far has had at least two faults present at once, so none of
    them resolved anything. This is the order to test in, with a known-good expected
    result for each step, so a failure identifies one thing instead of three.
    Phase 1 is contact and costs nothing. It includes a test that has never been run:
    the three electrodes measured pairwise and solved individually, since common-mode
    rejection dies on mismatch between electrodes rather than on absolute impedance,
    and one electrode an order of magnitude off the others would explain the mains
    coupling with no amplifier fault at all.
    Phase 2 records something easy to miss: the v3 needs ±3.5 V, a 9 V battery
    throu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
2026-10-04 Hero Heading
    Removing the pill was too small a change to see, which was fair. The headline
    now carries the hero properly: clamp(40px, 7vw, 96px) against a flat 74px, so
    it reads about 94px on a typical desktop, a third larger, and scales with the
    viewport instead of stepping once at 860px. Tighter tracking and 0.98 leading,
    loosened to 1.06 on phones where it wraps and tight leading reads as cramped
    rather than deliberate. Body width goes to 960px so the longest line still fits
    unwrapped at full size, checked from 1920 down to 600.
    Also fixes why the previous change looked like it had not deployed. The asset
    version bumped with every release can only bust the CSS and JS a page links to,
    nev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
2026-10-04 Page Heading
    Three things.
    The ECG trace goes back to the bottom two thirds at its original opacity. The
    version that rose behind the headline is reverted.
    The headline moves out of the dark panel onto the page above it. A heading
    inside a filled box reads as a label for that box; on the page it is the page's
    heading, which is what it should have been. The panel keeps the supporting line,
    the call to action and the reading card, so it loses its top-heavy empty space
    and comes down from 560px to 400px minimum.
    The page widens from 1120px to 1340px, and the status band mirrors it so the
    header still lines up with the content beneath. The extra room goes into the
    heading, now up to 118px fro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
2026-10-04 Hero Panel Content
    Moving the headline out onto the page left the panel mostly empty, with a single
    line of text and a button floating in 400px of dark green.
    It now carries the product identity and a real description: Neurova Reach as a
    mono label, the one-line claim at 27px, and a paragraph saying what the three
    sensors actually do and that each is judged against a baseline measured on the
    wearer's own skin. That last point is the thing that distinguishes this from a
    fitness tracker, and it was nowhere on the page.
    Neurova was already in the topbar and as the ghost wordmark at the foot, but
    neither reads as presence. Pairing it with the product name at the top of the
    panel puts the compa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
2026-10-04 Hero Brand
    Neurova was set as a 12px mono caption, which is how you label a panel rather
    than how you put a name on one. It is now display size, clamp(30px, 3.4vw,
    46px) in the heading face, with Reach in the accent so the product reads as
    distinct from the company without a second line explaining that.
    The description was a 35-word sentence listing all three sensors and then
    qualifying itself. Cut to one line that keeps the part that matters -- the
    baseline comes from the wearer's own skin -- since the three sensors already
    have a card each further down the page.
    Both remaining lines go up in weight, 600 for the claim and 500 for the line
    under it, and the muted text lifts from 62% to 78%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
2026-10-04 Hero Copy
    "Reads the nerve, not the guesswork" is an antithesis, and a balanced negation
    is one of the more recognisable marks of copy written to sound good rather than
    to say something. It also sat directly under a headline doing the same thing,
    "See, Not Just Feel", so the panel opened with the construction twice.
    It now says what the thing does: tracks nerve recovery in your hand.
    The line below was passive and abstract -- "judged against a baseline measured
    on your own skin" -- where the behaviour is an ordinary sequence. Calibrates to
    your skin first, then logs every session over time. Same facts, stated as
    actions in the order they happen.
2026-10-04 Hero Copy #2
    Skin to body in the hero panel's second line. Calibration is a property of the
    person wearing it, and body says that without narrowing it to the one tissue
    the electrode happens to touch.
2026-10-04 Hero Copy #3
    Italicise your in the hero panel's second line, matching the emphasis the
    calibration screen already puts on the same word.
2026-10-04 Test Menu Copy
    Run A Test / On Your Own Hand read like a translated instruction manual, and
    the line under it ended on an absolute -- nothing else means anything without
    it -- which is a flourish rather than information.
    Heading now carries the part that is actually unusual about this page, that the
    board is driven from the browser, and the lead carries what to do and why the
    order matters. Taken from two separate options and combined, because each one's
    own heading and lead said the same thing twice.
2026-10-04 Glove Not Board
    The site called the device a board in thirteen places, which is what it is to
    whoever wired it and not what it is to whoever wears it. Connect the board is
    now Connect your glove, and the status chip reads Glove connected against No
    glove connected.
    Also covers the phrases around it: the browser talks to your glove, the raw log
    is the glove's, the EMG trace turns green for as long as the glove judges you
    to be contracting, and nothing is sent anywhere but your glove.
    Internal names are untouched -- boardBaseline, parseBoardBaselineLine and the
    comments describing what the firmware does are about the firmware, and renaming
    those would make the code lie about which side of th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
2026-10-04 Test Menu Copy #2
    Test Menu / Wired To Your Glove, with a lead that says the readings come off
    the hand you are wearing it on.
    Neither line explains the test order any more. The greyed-out cards and the
    numbered steps already show it, so saying it again in prose was the copy doing
    a job the interface had already done. Nothing refers to what is finished and
    what is not either, so this does not need revisiting when the remaining tests
    land.
2026-10-04 Home Heading Weight
    Carrying the display heading to the test menu made home look like one more
    page rather than the front of the site -- same size, same leading, same grey
    second line. Every page opening the same way is consistency at the cost of
    hierarchy.
    Home now runs to 144px against 118px elsewhere, pulls its leading to 0.9 so
    the two lines lock into one block rather than reading as two stacked lines,
    tightens tracking to -0.05em at that size, and takes the brand green on the
    second line instead of the grey the other pages use. Space Grotesk stops at
    700, so none of this could come from weight.
    Measured at 1440px: 136.8px type, 246px tall, longest line 1170px of 1284px
    available. Fits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
2026-10-04 Heading Rule Removed
    Takes the underline back off. It was decoration added beneath an otherwise
    unchanged heading, when what the home page needs is a different arrangement
    rather than an ornament attached to the same one.
    The staggered rise stays for now.
2026-10-04 Inline Imagery
    Home's heading now carries the product inside the sentence: Your Hand Recovers.
    / [chip] This Proves It. The chip sits in the noun position that This refers
    to, so the image is the subject of the second line rather than an illustration
    beside it.
    Holding a pulse trace on the dark panel colour until there is a photo of the
    glove to put in it. The shape, the line breaks and the baseline are settled
    now, so the photo is a one-element swap and nothing reflows when it lands.
    One bug on the way: the staggered entrance used h1 span{display:block}, which
    also matched the chip and knocked it onto a line of its own. Scoped to the two
    line spans.
    Measured at 1440px, both lines single,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
2026-10-04 Glove Glyph
    A photo was the wrong answer. The prototype does not look like the product and
    the product is not designed yet, so a photo would show something misleading and
    a render would be a guess with a product shot's authority.
    An illustration has neither problem, and the site already had the language for
    it -- step 01 of How It Works is a line-art hand in the same stroke weight. The
    chip now carries that hand with a cuff and two electrodes, and the reading
    running out of it to the right, toward the words it is evidence for.
    First attempt put the hand small on the right with the trace filling the width.
    The two competed and the hand lost. Glove on the left at 1.2x with a shorter
    trace re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
2026-10-04 Render Templates
    Blender scripts and settings for a product render, so the modelling is the only
    part left by hand. The split matters: geometry is sculpted and cannot be
    scripted, but camera, lights, materials and output all can be, and those are
    what decide whether a render reads as a product shot or a 3D exercise.
    scene_setup.py is a 90mm camera at 62cm with depth of field on a focus empty,
    a three-point rig scaled to a hand-sized subject, transparent film and AgX.
    glove_shell.py subdivides and shrinkwraps a duplicate of a hand mesh, then
    solidifies it -- which is what a glove is, and the one hard step that scripts
    cleanly. materials.py carries the fabric, stud and cable shaders.
    Every P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
2026-10-04 Render Templates #2
    Adds the two steps the guide assumed. How to run a script -- the Scripting tab,
    Alt+P, and the System Console, which on macOS is hidden by default so a script
    that stops says nothing about why. Also which object has to be active before
    each one, since two of the three read the selection.
    And how to use the base meshes, which arrive as a .blend. That is a Blender
    file rather than a model format, so it is File > Append into Object, not Open,
    which would throw away the scene. Then splitting a hand off a whole body with
    P > Selection.
    The part that would have cost an afternoon: apply the scale first. glove_shell
    works in real units, 1.5mm of offset and 1.2mm of thickness, a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
2026-10-04 Render Templates #4
    Corrects the instruction for seeing script output. Window > Toggle System
    Console is Windows only and does not exist on macOS, so the guide pointed at a
    menu item that is not there. On macOS, Blender has to be started from Terminal
    for print output to go anywhere visible.
    Also says plainly not to paste a script into the Python Console. It executes a
    line at a time, so a pasted function body returns IndentationError on every
    indented line and nothing runs -- which looks like a broken script rather than
    the wrong panel.
2026-10-22 Rebuild Order
    Adds flex to CHECK, which already covered rail, contact and EMG idle against a
    saved reference. With flex in it, one command is a full regression over every
    subsystem, which is what a staged rebuild needs: add one thing, test that
    thing, then confirm nothing underneath it moved.
    A reference written by an earlier build has no flex slot, so a missing value
    reads as zero and the flex comparison is skipped rather than reporting a false
    delta against nothing.
    REBUILD-ORDER.md is the ladder itself. Contact first, because it is the most
    proven subsystem and the only one that does not use the ground rail. Then the
    rail, the flex, the supply with nothing on it, the sensor with no elec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
2026-10-22 Rebuild Order #2
    Reorders the ladder to reach EMG third instead of sixth. EMG is the only part
    that has never worked, so it holds all the remaining uncertainty, and it does
    not depend on the glove mounting -- only on contact being adequate during the
    test, which hand pressure provides at a repeatable 400-450 counts.
    Building the glove first would have meant days of mechanical work ahead of
    knowing whether the front end can work at all. If the amplifier turns out to be
    wrong, that work was spent on a dead end.
    Two stages stay ahead of it. The supply, because the sensor needs ±3.5 V, the
    battery measured 0.9 V, and a virtual ground off 5 V reaches ±2.5 V -- so an
    EMG test without a verifie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
2026-10-22 Rebuild Order #3
    Expands each stage into numbered steps with the sub-order inside it, which
    matters more than the stage order in two places.
    The probe is built and validated against the Arduino's own 5V pin before the
    supply it will measure exists. A rail reading taken with an unverified probe is
    worth nothing, and that exact mistake cost an evening when a 100k divider's
    source impedance made the readings contradict each other.
    The free interference fixes come before the first EMG reading rather than after
    a disappointing one -- unplug the laptop, twist the leads. And contact is
    measured with the jack out immediately before the jack goes in, because that
    reading is the only thing that make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
